schmolmo/distel-hardware/dxf/distel_front_1234_plexi.dxf

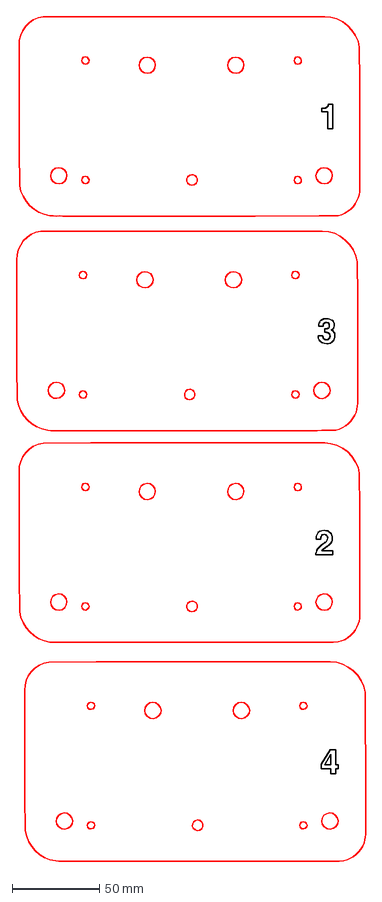
[picture p1: CAD file, 2024-02-03]
dxf/distel_front_1234_plexi.dxf
200.7 x 485.1 mm
