schmolmo/distel-hardware/dxf/distel_back_mdf.dxf

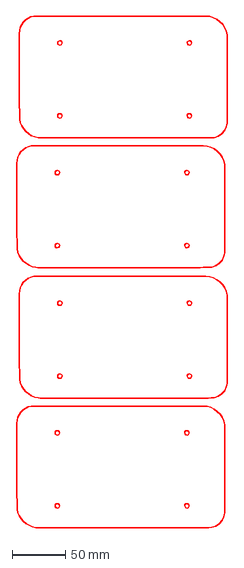
[picture p2: CAD file, 2024-02-03]
dxf/distel_back_mdf.dxf
198.5 x 481.4 mm
