schmolmo/distel-hardware/dxf/distel_front_5678_plexi.dxf

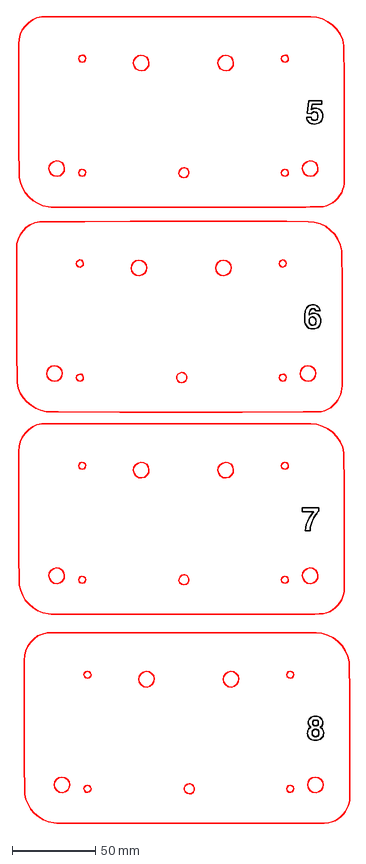
[picture p3: CAD file, 2024-02-03]
dxf/distel_front_5678_plexi.dxf
200.7 x 485.1 mm
