schmolmo/distel-hardware/kicad/v2_atmega8_encoder.kicad_pcb

## KiCad design kicad/v2_atmega8_encoder.kicad_pcb (2024-01-31)

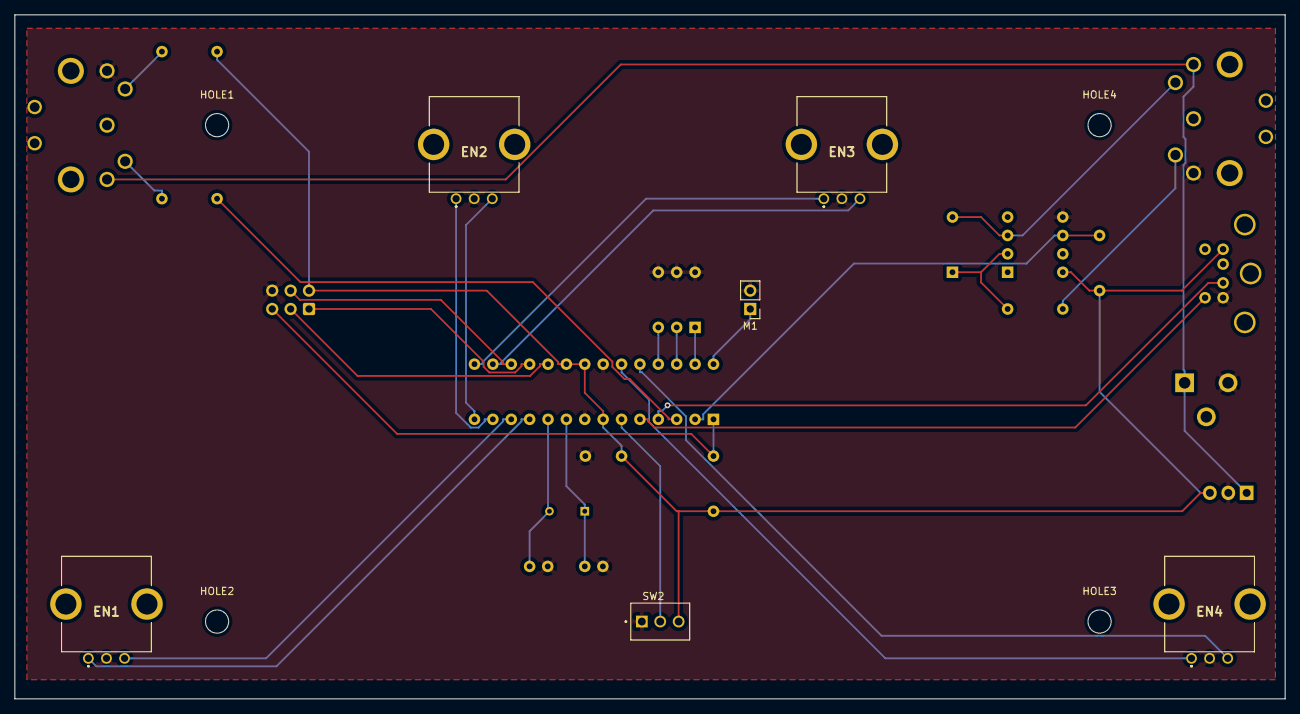
[picture p4: board v2_atmega8_encoder.kicad_pcb from above]

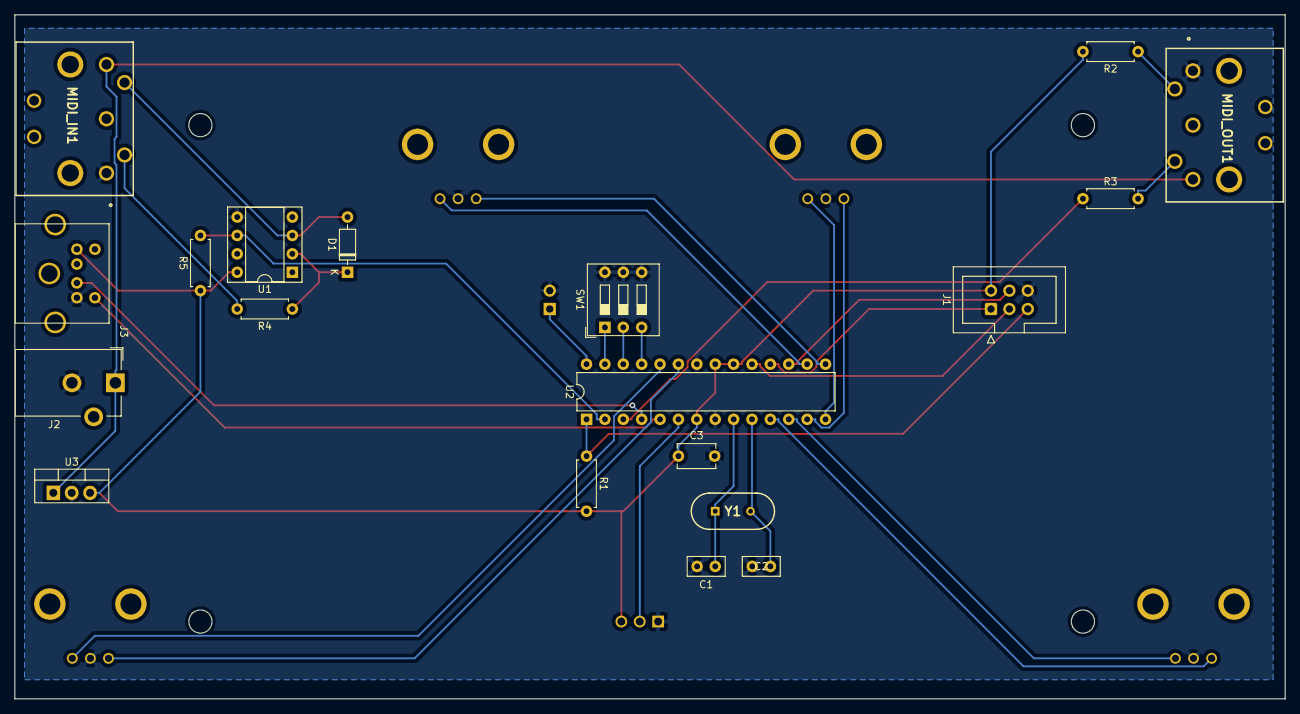
[picture p5: board v2_atmega8_encoder.kicad_pcb from below]

Board: 2 copper layers, 175.5 x 94.5 mm, 29 parts (19 on the bottom side), 31 nets.

Parts:
C1, C2: 22p; C_Disc_D5.0mm_W2.5mm_P2.50mm
C3: 100n; C_Disc_D5.1mm_W3.2mm_P5.00mm
D1: 1N914; D_DO-35_SOD27_P7.62mm_Horizontal
EN1, EN2, EN3, EN4: Rotary_Encoder; EC12E2430404
HOLE1, HOLE2, HOLE3, HOLE4: MountingHole_3.2mm_M3
J1: AVR-ISP-6; IDC-Header_2x03_P2.54mm_Vertical
J2: Jack-DC; BarrelJack_CUI_PJ-102AH_Horizontal
J3: Mini-DIN-6; mini-DIN 6
M1: Motor_DC; PinHeader_1x02_P2.54mm_Vertical
MIDI_IN1: DIN-5; MAB-5-SH
MIDI_OUT1: DIN-5; MAB-5-SH
R1: 10K; R_Axial_DIN0207_L6.3mm_D2.5mm_P7.62mm_Horizontal
R2, R3, R4, R5: 220; R_Axial_DIN0207_L6.3mm_D2.5mm_P7.62mm_Horizontal
SW1: SW_DIP_x03; SW_DIP_SPSTx03_Slide_9.78x9.8mm_W7.62mm_P2.54mm
SW2: SW_SPDT; SW_2MS1T1B1M2QES
U1: 6N138; DIP-8_W7.62mm_Socket
U2: ATmega8-16PU; DIP-28_W7.62mm
U3: L7805; TO-220-3_Vertical
Y1: 16 Mhz; ABL

Connections:
+5V: C3.1, J1.2, J3.3, R1.2, R2.2, R5.1, SW2.3, U1.8, U2.7, U2.20, U2.21, U3.3
+12V: J2.1, MIDI_IN1.3, MIDI_OUT1.3, U3.1
GND: C1.2, C2.2, C3.2, EN1.C, EN2.C, EN3.C, EN4.C, J1.6, J2.2, J3.4, M1.2, MIDI_IN1.1, MIDI_OUT1.1, SW1.4, SW1.5, SW1.6, SW2.1, U1.5, U2.8, U2.22, U3.2
unnamed: C1.1, U2.9, Y1.1
unnamed: C2.1, U2.10, Y1.2
unnamed: D1.1, R4.1, U1.2
unnamed: D1.2, MIDI_IN1.5, U1.3
unnamed: J1.1, U2.18
unnamed: J1.3, U2.19
unnamed: J1.4, U2.17
unnamed: J1.5, R1.1, U2.1
unnamed: J3.2, U2.4
unnamed: J3.6, U2.5
unnamed: M1.1, U2.28
unnamed: MIDI_IN1.4, R4.2
unnamed: MIDI_OUT1.4, R2.1
unnamed: MIDI_OUT1.5, R3.2
unnamed: SW1.1, U2.27
unnamed: SW1.2, U2.26
unnamed: SW1.3, U2.25
unnamed: SW2.2, U2.6
Pin11: EN1.A, U2.11
Pin12: EN1.B, U2.12
Pin13: EN2.A, U2.13
Pin14: EN2.B, U2.14
Pin15: EN3.A, U2.15
Pin16: EN3.B, U2.16
Pin23: EN4.A, U2.23
Pin24: EN4.B, U2.24
RX: R5.2, U1.6, U2.2
TX: R3.1, U2.3
