schmolmo/distel-hardware/(commit log)

2024-01-31 add DIP-Sockets and Knobs
    [BOM.csv]
2024-02-03 add lasercut files
    [distel_back_mdf.dxf, distel_front_1234_plexi.dxf, distel_front_5678_plexi.dxf]
